rob-scape/noisferatu/images/Noisferatu.webp

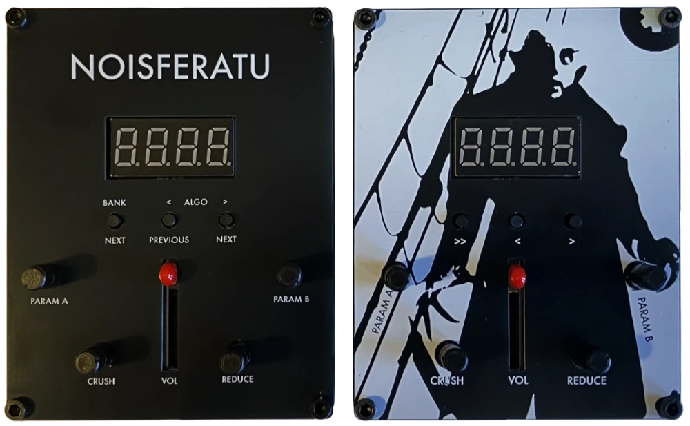
images/Noisferatu.webp
