rob-scape/noisferatu/schematic/Noisferatu_rev_3.pdf

3.3V

# GND GND GND

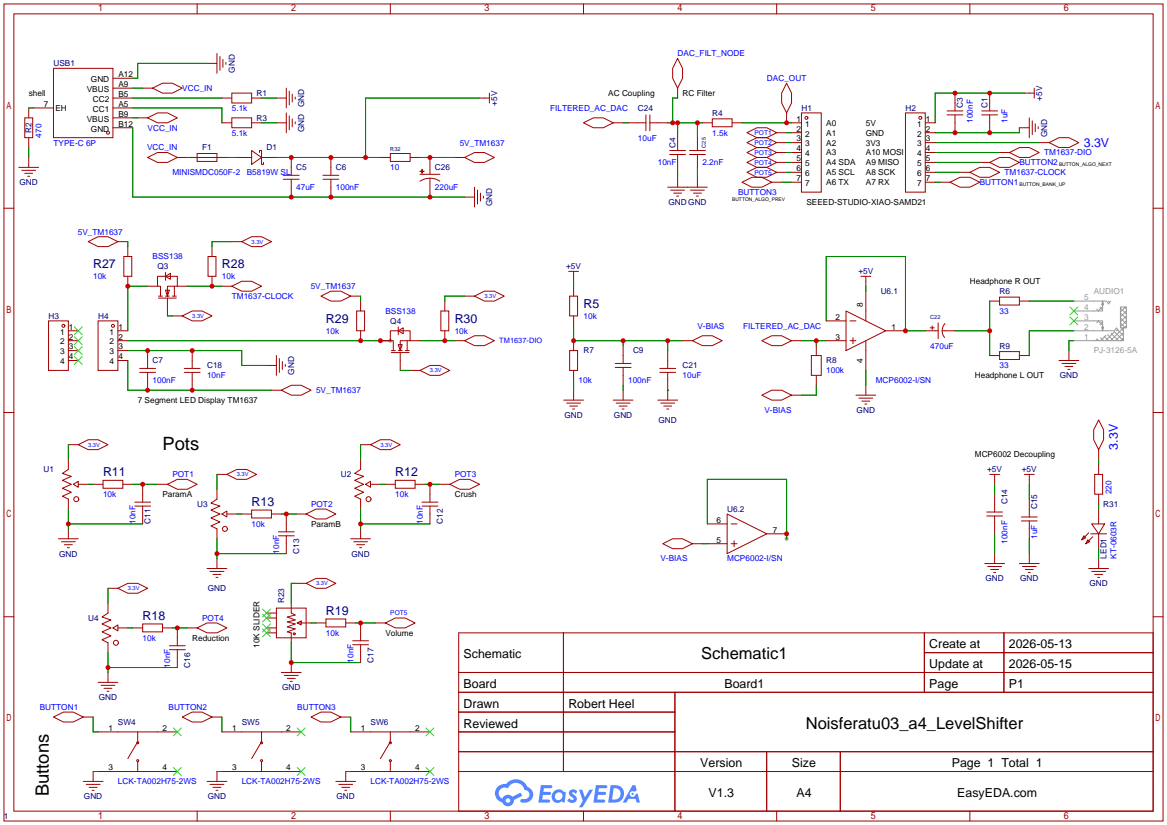
[picture p13: page 1]

Schematic | Schematic1 | Create at | 2026-05-13

Update at | 2026-05-15

Board | Board1 | Page | P1
Drawn | Robert Heel | Noisferatu03_a4_LevelShifter
Reviewed

Version | Size | Page 1 Total 1
V1.3 | A4 | EasyEDA.com
