rob-scape/noisferatu/firmware/Noisferatu/sample.h

#ifndef SAMPLE_H
#define SAMPLE_H
#include <Arduino.h>

#define VINYL_CRACKLE_SAMPLES 32000  // 64000 bytes / 2 = 8000 int16_t samples

//const int8_t vinylCrackle[64000] PROGMEM = {
const uint8_t vinylCrackle[64000] PROGMEM = {  

  0xee, 0xff, 0xb4, 0xff, 0xc2, 0x00, 0x11, 0x01, 0xa4, 0x02, 0x58, 0xff,
  0x18, 0xfe, 0x12, 0xff, 0x50, 0xff, 0xd1, 0x00, 0x6b, 0xff, 0xbc, 0xff,
  0xae, 0xff, 0xb5, 0x00, 0x05, 0x00, 0x6f, 0xff, 0x67, 0xff, 0xc5, 0xfe,
  0x22, 0x00, 0x0a, 0x00, 0xd8, 0xff, 0xe9, 0xfe, 0x68, 0x00, 0x5f, 0xff,
  0x40, 0x00, 0x00, 0x00, 0xb2, 0x00, 0x06, 0xff, 0xa7, 0x00, 0xdf, 0xff,
  0x6a, 0x00, 0xa3, 0xff, 0xc6, 0x00, 0xcc, 0xff, 0x35, 0x01, 0x88, 0xfe,
  0x14, 0xf9, 0x93, 0x04, 0x86, 0xff, 0x96, 0x02, 0x66, 0x00, 0xfc, 0x01,
  0x1b, 0xff, 0xf1, 0x00, 0x59, 0xff, 0xc0, 0x00, 0xfc, 0xfe, 0x51, 0x00,
  0x66, 0xff, 0xe0, 0x00, 0xf4, 0xff, 0xbb, 0xff, 0x2c, 0x00, 0x78, 0xff,
  0x05, 0x02, 0x8b, 0xfd, 0xa2, 0x02, 0xe2, 0xfc, 0xef, 0xfd, 0xe5, 0x99,
  0x92, 0xea, 0x4a, 0x3f, 0x1e, 0x12, 0x81, 0x1c, 0x02, 0x09, 0x24, 0x0d,
  0x90, 0x02, 0xca, 0x06, 0xcb, 0x00, 0xf6, 0x03, 0xf0, 0x00, 0xcd, 0x01,
  0x05, 0x01, 0x6d, 0x00, 0x42, 0x01, 0x3b, 0xff, 0xcc, 0xff, 0xf9, 0xfd,
  0x7e, 0xfe, 0x58, 0x00, 0xfa, 0x00, 0xbe, 0xff, 0x0f, 0x01, 0x5f, 0xff,
  0xc9, 0x00, 0xe7, 0xfe, 0x05, 0x00, 0xe7, 0xfe, 0x36, 0x00, 0xb1, 0xfe,
  0x7d, 0xff, 0xbe, 0xfe, 0xa4, 0xff, 0x81, 0xff, 0xcb, 0xff, 0x44, 0xfe,
  0x70, 0xff, 0x23, 0xfd, 0xed, 0xfc, 0x92, 0xfd, 0xd8, 0xfe, 0x3b, 0x00,
  0x84, 0xfe, 0x13, 0x00, 0x15, 0xff, 0x67, 0xff, 0xd4, 0xfe, 0xdf, 0xff,
  0x7a, 0xff, 0x9f, 0xff, 0x71, 0xff, 0x18, 0x00, 0x11, 0x00, 0xda, 0xff,
  0xd0, 0xff, 0x53, 0x00, 0xf8, 0xff, 0xaf, 0xff, 0xd0, 0xff, 0x7f, 0x00,
  0x88, 0x00, 0xa6, 0x00, 0x63, 0x00, 0xc1, 0xff, 0xca, 0x00, 0x7c, 0x00,
  0x1a, 0x01, 0x90, 0x00, 0x20, 0x00, 0x57, 0x00, 0x6b, 0x00, 0x7c, 0x00,
  0xa3, 0x00, 0x61, 0x00, 0x60, 0x00, 0x16, 0x01, 0xce, 0xff, 0x69, 0xff,
  0xc7, 0xff, 0xf2, 0xff, 0x77, 0x00, 0xbb, 0xff, 0xcd, 0xff, 0xaa, 0xff,
  0x36, 0x00, 0x5b, 0x00, 0x16, 0x00, 0x5f, 0x00, 0xe3, 0xff, 0xf4, 0x00,
  0xa5, 0x00, 0x8f, 0x01, 0x98, 0x00, 0x2e, 0x01, 0x21, 0x01, 0x58, 0x00,
  0xa8, 0x00, 0x57, 0x00, 0xcc, 0x01, 0xac, 0x00, 0xba, 0x00, 0x53, 0xff,
  0xd2, 0xff, 0x3d, 0x00, 0x01, 0x00, 0x47, 0xff, 0xc0, 0xfe, 0xeb, 0xff,
  0x2f, 0xff, 0x54, 0xff, 0x05, 0x00, 0x86, 0xff, 0xbf, 0xff, 0xe8, 0xfe,
  0x31, 0xfe, 0x5a, 0xff, 0x69, 0xfe, 0xf1, 0xfe, 0xc9, 0xfe, 0x6d, 0xfe,
  0xf3, 0xfe, 0x22, 0xfe, 0x5f, 0xfe, 0xc2, 0xfe, 0xa2, 0xfe, 0x10, 0xfe,
  0xf6, 0xfd, 0x4d, 0xfe, 0x44, 0xfe, 0x39, 0xff, 0xff, 0xfe, 0xe0, 0xfe,
  0xc0, 0xfe, 0x0d, 0xff, 0x8c, 0xfe, 0xde, 0xfe, 0xee, 0xfe, 0x19, 0xfe,
  0xb8, 0xfe, 0x1a, 0xff, 0xae, 0xff, 0x59, 0xfe, 0x5d, 0xff, 0x3a, 0xff,
  0xe8, 0xfe, 0x1f, 0x00, 0x81, 0xff, 0x25, 0x01, 0x6e, 0x00, 0x5b, 0xff,
  0x25, 0x00, 0x41, 0xff, 0xb4, 0xff, 0xd2, 0xfe, 0xb5, 0xfe, 0x7e, 0xfe,
  0x70, 0xff, 0xe2, 0xff, 0x80, 0xff, 0x71, 0x00, 0xeb, 0xff, 0x06, 0xff,
  0x80, 0xff, 0xde, 0xff, 0xff, 0xff, 0x2a, 0x01, 0x62, 0x01, 0x84, 0x00,
  0xf0, 0xff, 0x7a, 0x00, 0x96, 0xff, 0x7b, 0x02, 0xd6, 0x00, 0x28, 0x00,
  0xab, 0x01, 0xb0, 0x01, 0x61, 0x00, 0xba, 0x00, 0x5c, 0x02, 0x3f, 0x01,
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
  };

#endif
